BiocomputeLab/bolt/BOLT_Housing_STLs/plate_elevator.stl

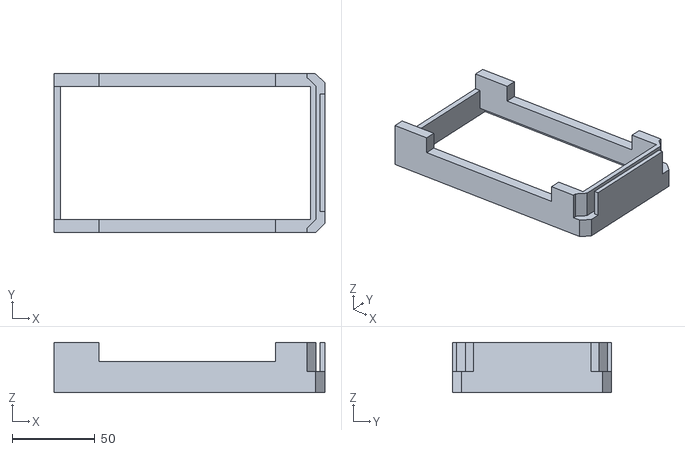
[picture p6: CAD file, 2026-10-31]
BOLT_Housing_STLs/plate_elevator.stl
163.4 x 95.9 x 30.3
