BiocomputeLab/bolt/BOLT_Housing_STLs/96-well_light_isolator.stl

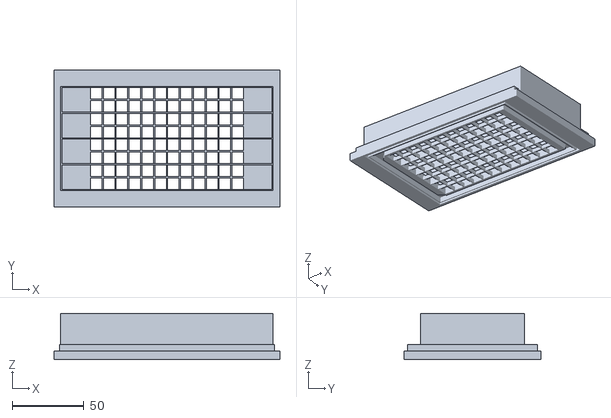
[picture p7: CAD file, 2026-10-31]
BOLT_Housing_STLs/96-well_light_isolator.stl
158.0 x 95.7 x 32.4
