BiocomputeLab/bolt/BOLT_Housing_STLs/24-well_lid.stl

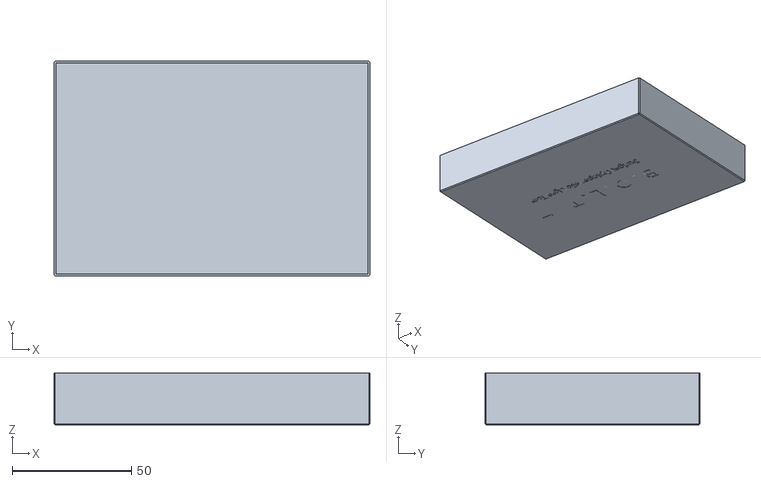
[picture p8: CAD file, 2026-10-31]
BOLT_Housing_STLs/24-well_lid.stl
132.3 x 90.0 x 21.8
