BiocomputeLab/bolt/BOLT_Housing_STLs/24-well_light_isolator.stl

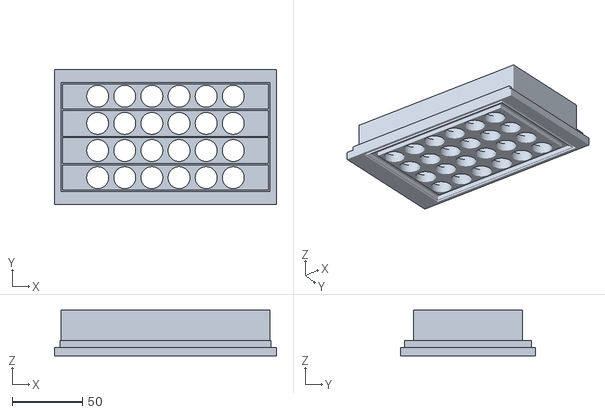
[picture p9: CAD file, 2026-10-31]
BOLT_Housing_STLs/24-well_light_isolator.stl
157.9 x 95.7 x 32.4
