BiocomputeLab/bolt/BOLT_Housing_STLs/LED_base.stl

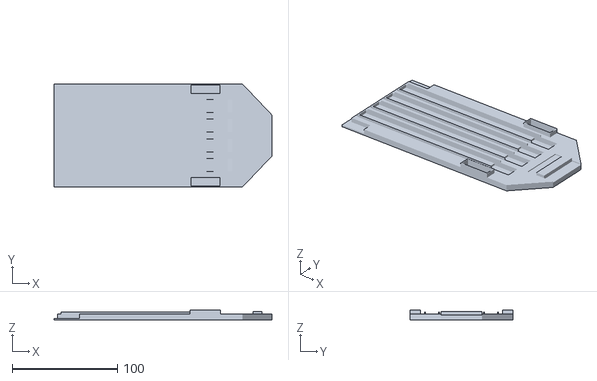
[picture p10: CAD file, 2026-10-31]
BOLT_Housing_STLs/LED_base.stl
207.6 x 97.9 x 9.75
