BiocomputeLab/bolt/BOLT_Housing_STLs/electronics_housing.stl

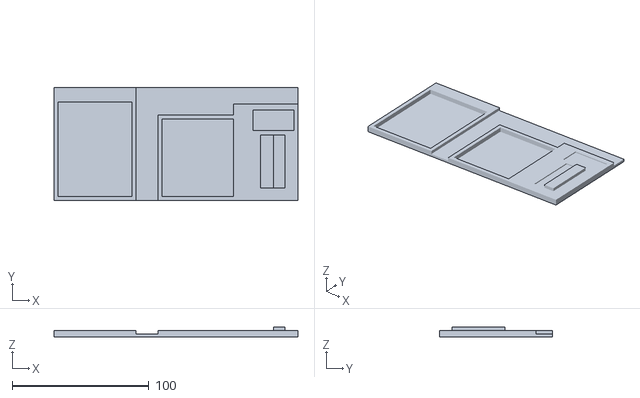
[picture p11: CAD file, 2026-10-31]
BOLT_Housing_STLs/electronics_housing.stl
178.2 x 82.5 x 7.00
