BiocomputeLab/bolt/BOLT_Housing_STLs/96-well_lid.stl

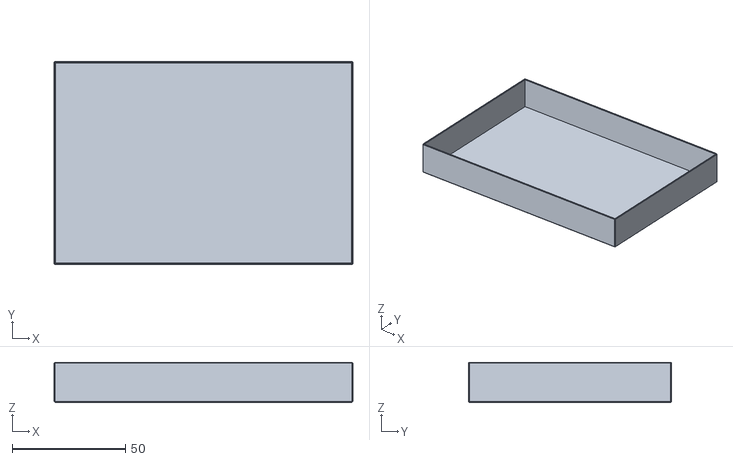
[picture p12: CAD file, 2026-10-31]
BOLT_Housing_STLs/96-well_lid.stl
132.3 x 90.0 x 17.8
