BiocomputeLab/bolt/(commit log)

2026-10-31 Add BOLT firmware, GUI, housing STLs, and documentation
    - bolt_firmware/bolt_firmware.ino: Arduino Uno sketch driving 4
    independent LED channels (continuous or pulsed, per-channel duration,
    delayed start)
    - bolt_gui.py: Tkinter control GUI (protocol config, live preview/
    simulation, save/load protocols)
    - BOLT_Housing_STLs/: 3D-printable housing for 24-well (Corning Costar
    #3524) and 96-well (Greiner Bio-One #655101) plate formats
    - README.md: full build, wiring, and usage documentation with figures
    - pyproject.toml: packaging for `pip install .` / `bolt-gui` command
    [24-well_lid.stl, 24-well_light_isolator.stl, 96-well_lid.stl, 96-well_light_isolator.stl, LED_base.stl, electronics_housing.stl, plate_elevator.stl]
2026-10-31 Clarify that supports are only needed for plate_elevator.stl
